benmalenfant/OpenSimRadio/docs/kx155-picture.webp

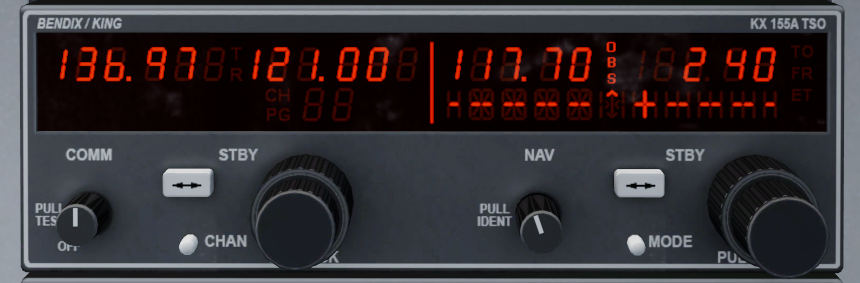
docs/kx155-picture.webp
