benmalenfant/OpenSimRadio/README.md

# OpenSimRadio
Open sourced radio stack for flight simulation (Work in progress, not finished)
