benmalenfant/OpenSimRadio/docs/kx-165a drawings.pdf

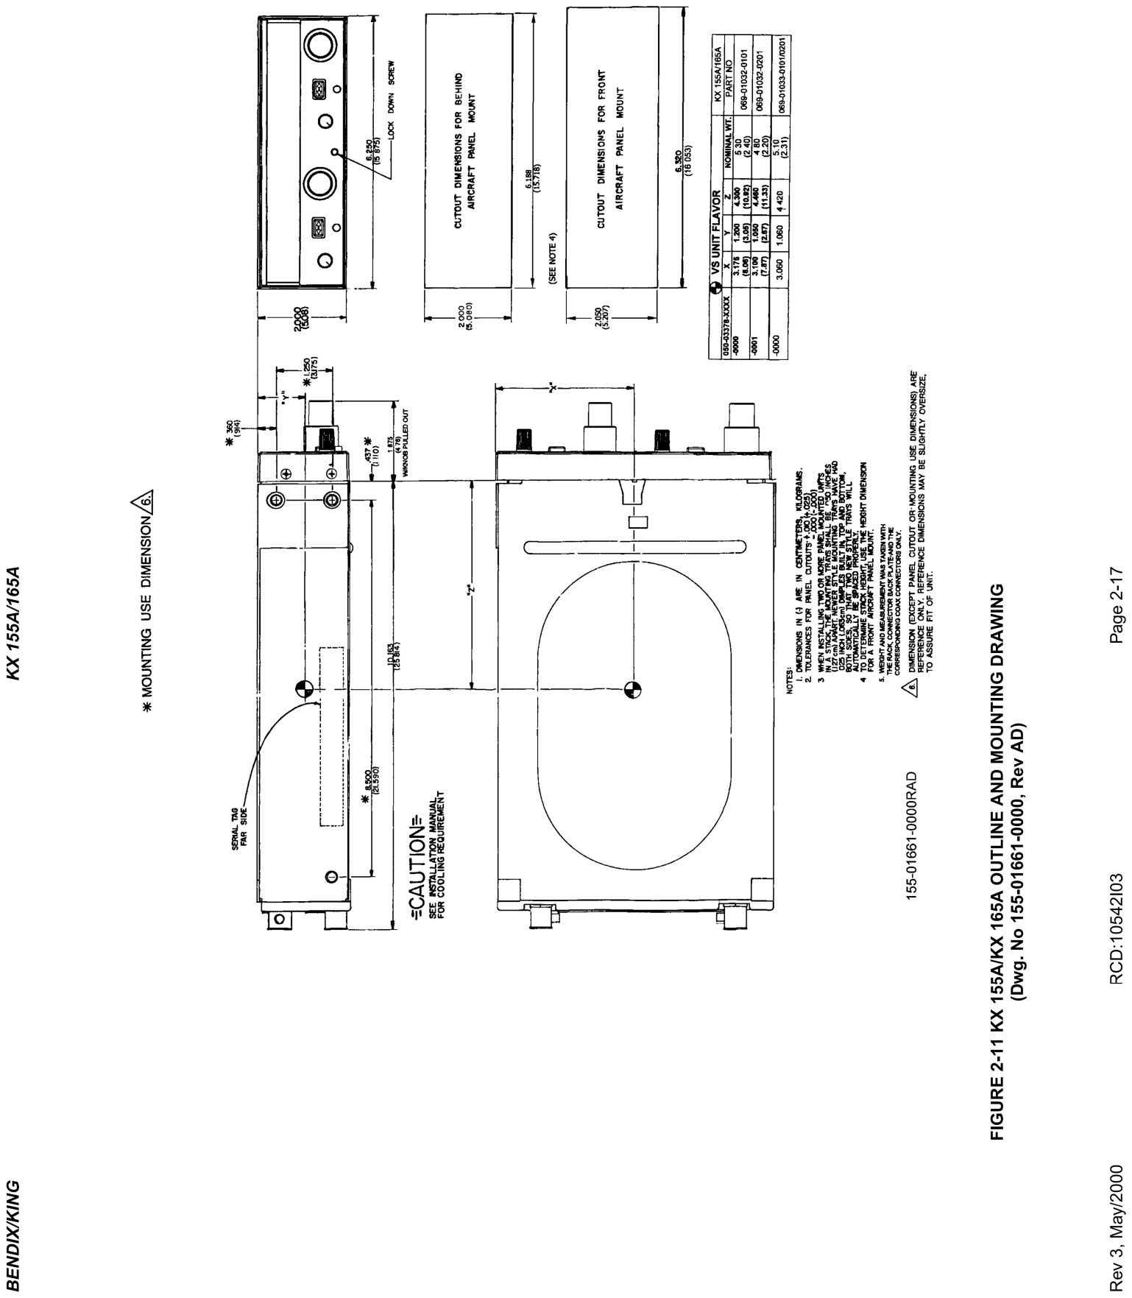
[picture p2: page 1]
