benmalenfant/OpenSimRadio/docs/KX-165_Face_Drawing.png

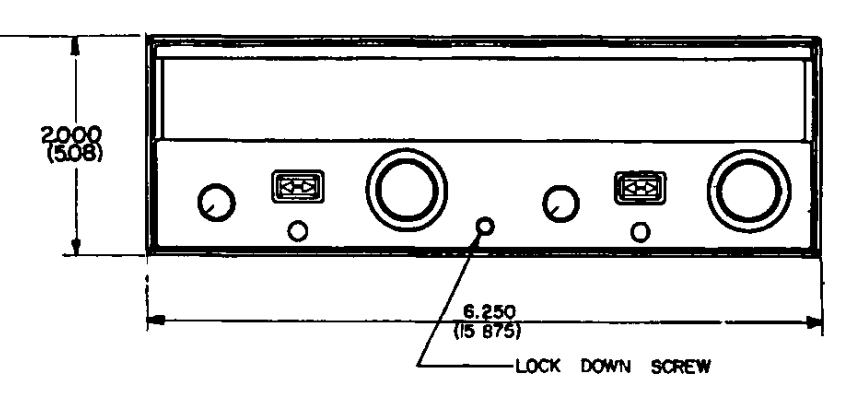
docs/KX-165_Face_Drawing.png
