benmalenfant/OpenSimRadio/(list of files, cad)

Other CAD files:
Com-Nav Unit/Mechanical/Draft.FCStd
