benmalenfant/OpenSimRadio/Com-Nav Unit/PCB/Com-Nav-Radio.kicad_pcb

## KiCad design Com-Nav Unit/PCB/Com-Nav-Radio.kicad_pcb (2025-05-04)

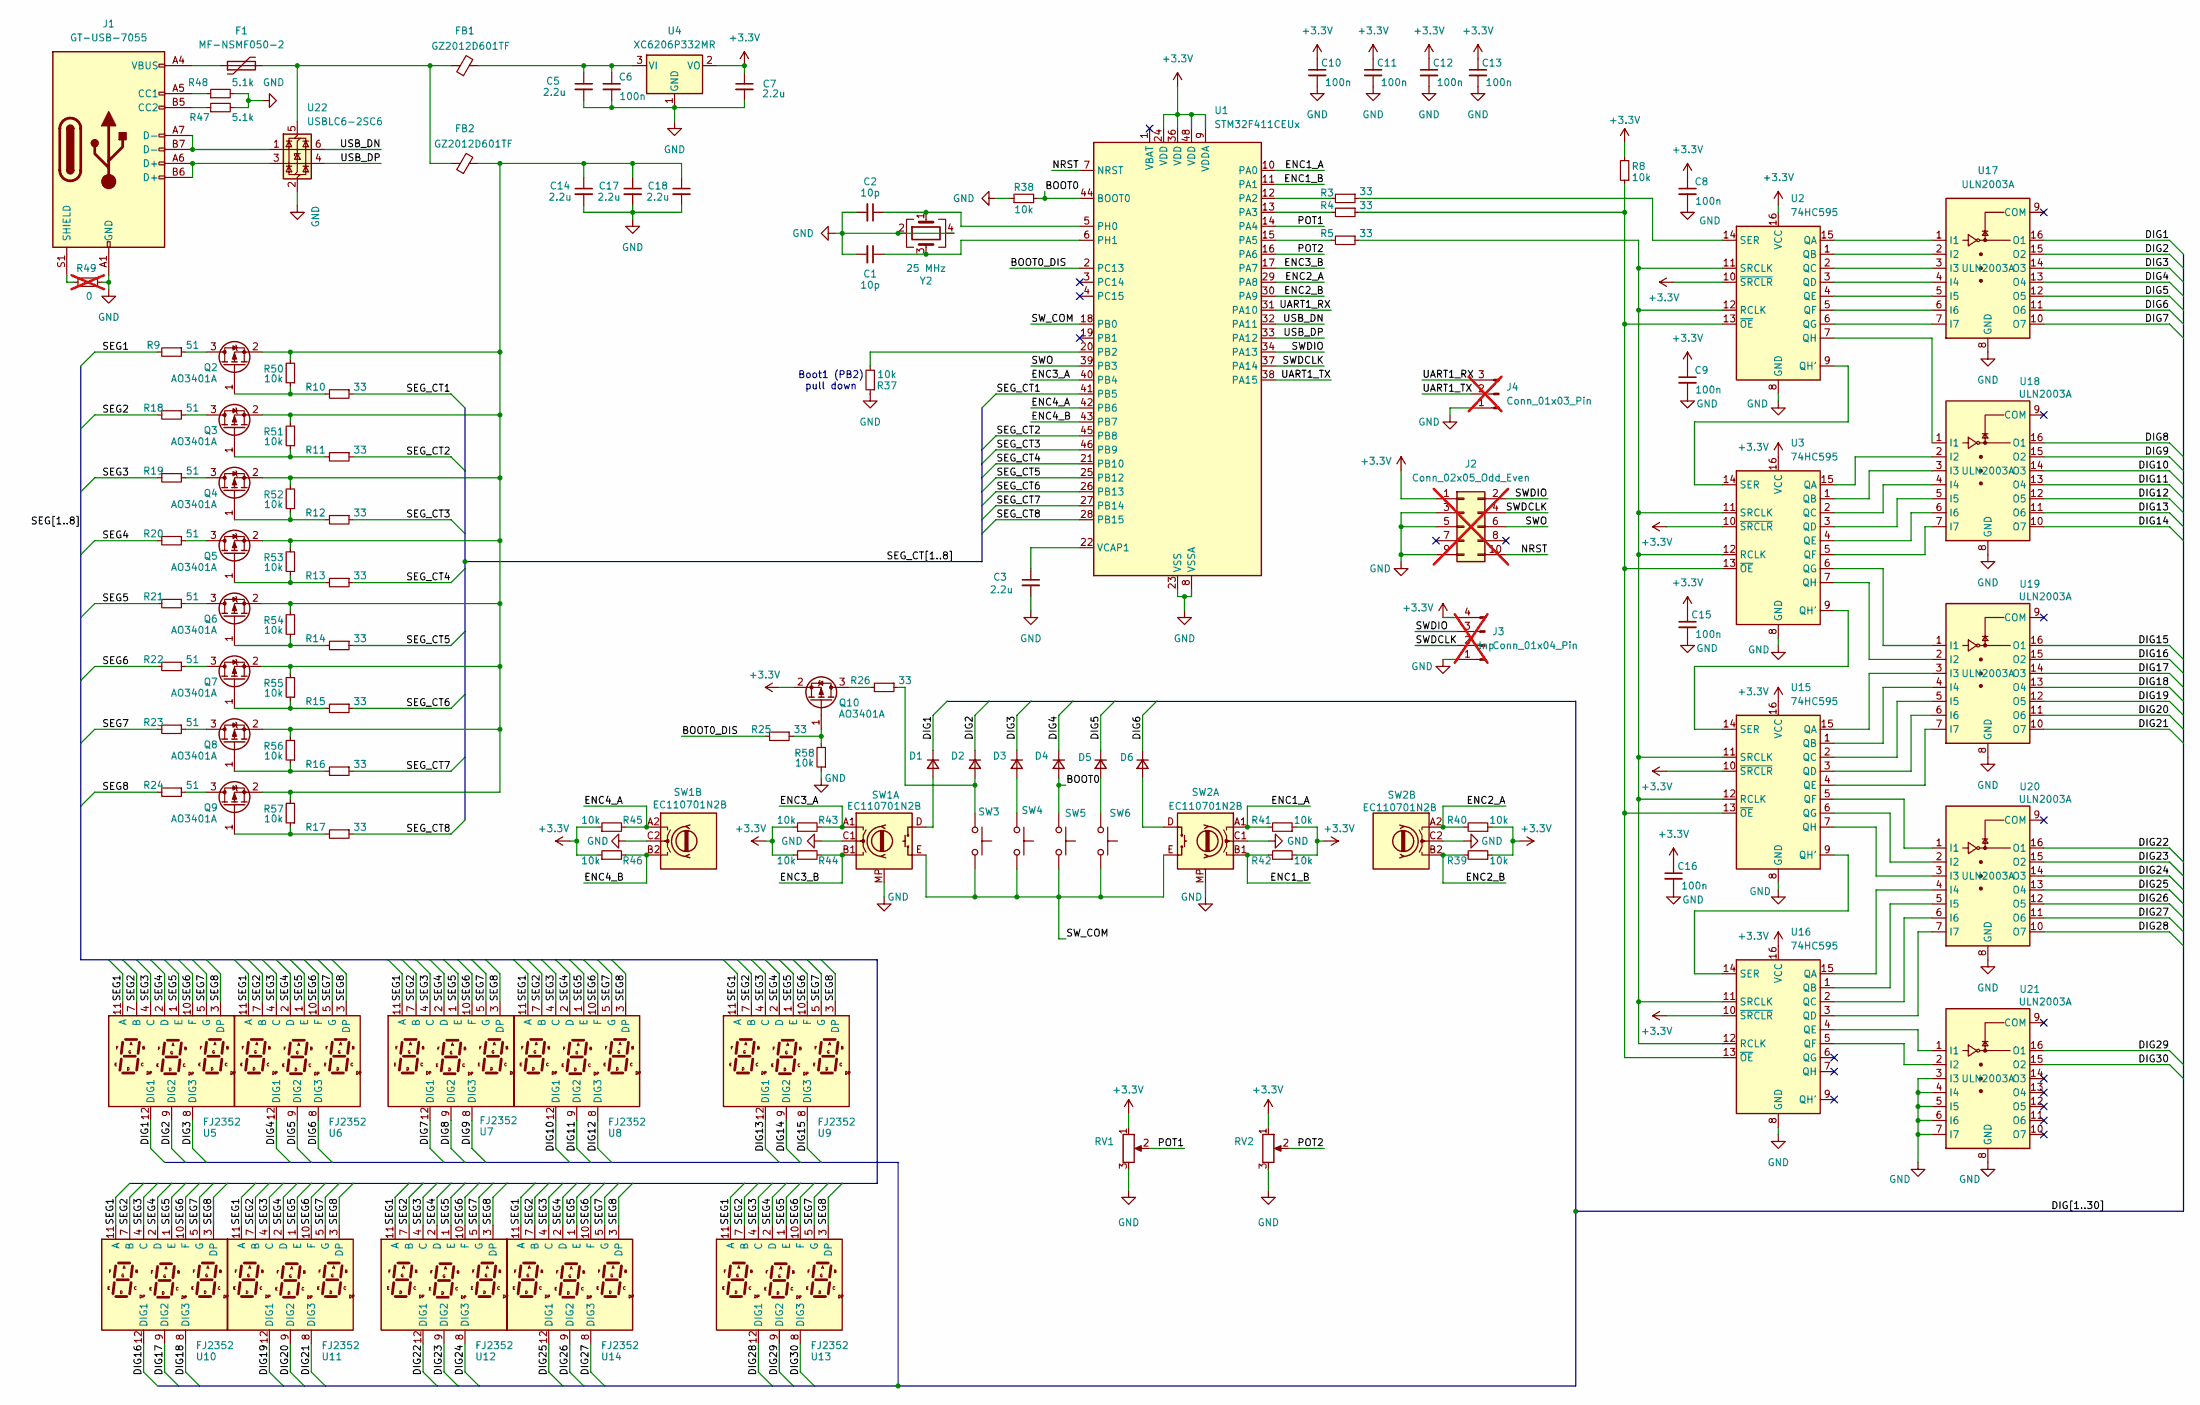
[picture p4: schematic Com-Nav-Radio.kicad_sch, Com-Nav-Radio Unit]

Parts:
C1, C2: 10p; C_0402_1005Metric
C3, C5, C7, C14, C17, C18: 2.2u; C_0603_1608Metric
C6, C8, C9, C10, C11, C12, C13, C15, C16: 100n; C_0402_1005Metric
D1, D2, D3, D4, D5, D6: 1N5819WS; D_SOD-323
F1: MF-NSMF050-2; Fuse_1206_3216Metric
FB1, FB2: GZ2012D601TF; L_0805_2012Metric
J1: GT-USB-7055; USB_C_Receptacle_G-Switch_GT-USB-7055x
J2: Conn_02x05_Odd_Even; PinHeader_2x05_P1.27mm_Vertical_SMD; not fitted
J3: Conn_01x04_Pin; PinHeader_1x04_P2.54mm_Vertical; not fitted
J4: Conn_01x03_Pin; PinHeader_1x03_P2.54mm_Vertical; not fitted
Q2, Q3, Q4, Q5, Q6, Q7, Q8, Q9, Q10: AO3401A; SOT-23
R3, R4, R5, R10, R11, R12, R13, R14, R15, R16, R17, R25, R26: 33; R_0402_1005Metric
R8, R37, R38, R39, R40, R41, R42, R43, R44, R45, R46, R50, R51, R52, R53, R54, R55, R56, R57, R58: 10k; R_0402_1005Metric
R9, R18, R19, R20, R21, R22, R23, R24: 51; R_0805_2012Metric
R47, R48: 5.1k; R_0402_1005Metric
R49: 0; R_0603_1608Metric; not fitted
RV1, RV2: RA0901N0X0D; RA0901N0X0D-HA1
SW1, SW2: EC110701N2B; EC11EBB24C03_EC110701N2B
SW3, SW4, SW5, SW6: SW_Push; SW_PUSH_6mm
U1: STM32F411CEUx; QFN-48-1EP_7x7mm_P0.5mm_EP5.6x5.6mm
U2, U3, U15, U16: 74HC595; SOIC-16_3.9x9.9mm_P1.27mm
U4: XC6206P332MR; SOT-23-3
U5, U6, U7, U8, U9, U10, U11, U12, U13, U14: FJ2352
U17, U18, U19, U20, U21: ULN2003A; SOIC-16_3.9x9.9mm_P1.27mm
U22: USBLC6-2SC6; SOT-23-6
Y2: 25 MHz; Crystal_SMD_3225-4Pin_3.2x2.5mm

Connections:
+3.3V: C7.1, C8.1, C9.1, C10.1, C11.1, C12.1, C13.1, C15.1, C16.1, J2.1, J3.4, Q10.2 (S), R8.2, R39.1, R40.1, R41.1, R42.1, R43.1, R44.1, R45.1, R46.1, RV1.1, RV2.1, U1.9 (VDDA), U1.24 (VDD), U1.36 (VDD), U1.48 (VDD), U2.10 (~SRCLR), U2.16 (VCC), U3.10 (~SRCLR), U3.16 (VCC), U4.2 (VO), U15.10 (~SRCLR), U15.16 (VCC), U16.10 (~SRCLR), U16.16 (VCC)
/BOOT0: D4.2 (A), R38.2, SW5.2, U1.44 (BOOT0)
/DIG1: D1.1 (K), U5.12 (DIG1), U17.16 (O1)
/DIG2: D2.1 (K), U5.9 (DIG2), U17.15 (O2)
/DIG3: D3.1 (K), U5.8 (DIG3), U17.14 (O3)
/DIG4: D4.1 (K), U6.12 (DIG1), U17.13 (O4)
/DIG5: D5.1 (K), U6.9 (DIG2), U17.12 (O5)
/DIG6: D6.1 (K), U6.8 (DIG3), U17.11 (O6)
/DIG7: U7.12 (DIG1), U17.10 (O7)
/DIG8: U7.9 (DIG2), U18.16 (O1)
/DIG9: U7.8 (DIG3), U18.15 (O2)
/DIG10: U8.12 (DIG1), U18.14 (O3)
/DIG11: U8.9 (DIG2), U18.13 (O4)
/DIG12: U8.8 (DIG3), U18.12 (O5)
/DIG13: U9.12 (DIG1), U18.11 (O6)
/DIG14: U9.9 (DIG2), U18.10 (O7)
/DIG15: U9.8 (DIG3), U19.16 (O1)
/DIG16: U10.12 (DIG1), U19.15 (O2)
/DIG17: U10.9 (DIG2), U19.14 (O3)
/DIG18: U10.8 (DIG3), U19.13 (O4)
/DIG19: U11.12 (DIG1), U19.12 (O5)
/DIG20: U11.9 (DIG2), U19.11 (O6)
/DIG21: U11.8 (DIG3), U19.10 (O7)
/DIG22: U12.12 (DIG1), U20.16 (O1)
/DIG23: U12.9 (DIG2), U20.15 (O2)
/DIG24: U12.8 (DIG3), U20.14 (O3)
/DIG25: U14.12 (DIG1), U20.13 (O4)
/DIG26: U14.9 (DIG2), U20.12 (O5)
/DIG27: U14.8 (DIG3), U20.11 (O6)
/DIG28: U13.12 (DIG1), U20.10 (O7)
/DIG29: U13.9 (DIG2), U21.16 (O1)
/DIG30: U13.8 (DIG3), U21.15 (O2)
/ENC1_A: R41.2, SW2.A1, U1.10 (PA0)
/ENC1_B: R42.2, SW2.B1, U1.11 (PA1)
/ENC2_A: R40.2, SW2.A2, U1.29 (PA8)
/ENC2_B: R39.2, SW2.B2, U1.30 (PA9)
/ENC3_A: R43.2, SW1.A1, U1.40 (PB4)
/ENC3_B: R44.2, SW1.B1, U1.17 (PA7)
/ENC4_A: R45.2, SW1.A2, U1.42 (PB6)
/ENC4_B: R46.2, SW1.B2, U1.43 (PB7)
/NRST: J2.10, U1.7 (NRST)
/POT1: RV1.2, U1.14 (PA4)
/POT2: RV2.2, U1.16 (PA6)
/SEG1: R9.2, U5.11 (A), U6.11 (A), U7.11 (A), U8.11 (A), U9.11 (A), U10.11 (A), U11.11 (A), U12.11 (A), U13.11 (A), U14.11 (A)
/SEG2: R18.2, U5.7 (B), U6.7 (B), U7.7 (B), U8.7 (B), U9.7 (B), U10.7 (B), U11.7 (B), U12.7 (B), U13.7 (B), U14.7 (B)
/SEG3: R19.2, U5.4 (C), U6.4 (C), U7.4 (C), U8.4 (C), U9.4 (C), U10.4 (C), U11.4 (C), U12.4 (C), U13.4 (C), U14.4 (C)
/SEG4: R20.2, U5.2 (D), U6.2 (D), U7.2 (D), U8.2 (D), U9.2 (D), U10.2 (D), U11.2 (D), U12.2 (D), U13.2 (D), U14.2 (D)
/SEG5: R21.2, U5.1 (E), U6.1 (E), U7.1 (E), U8.1 (E), U9.1 (E), U10.1 (E), U11.1 (E), U12.1 (E), U13.1 (E), U14.1 (E)
/SEG6: R22.2, U5.10 (F), U6.10 (F), U7.10 (F), U8.10 (F), U9.10 (F), U10.10 (F), U11.10 (F), U12.10 (F), U13.10 (F), U14.10 (F)
/SEG7: R23.2, U5.5 (G), U6.5 (G), U7.5 (G), U8.5 (G), U9.5 (G), U10.5 (G), U11.5 (G), U12.5 (G), U13.5 (G), U14.5 (G)
/SEG8: R24.2, U5.3 (DP), U6.3 (DP), U7.3 (DP), U8.3 (DP), U9.3 (DP), U10.3 (DP), U11.3 (DP), U12.3 (DP), U13.3 (DP), U14.3 (DP)
/SEG_CT1: R10.1, U1.41 (PB5)
/SEG_CT2: R11.1, U1.45 (PB8)
/SEG_CT3: R12.1, U1.46 (PB9)
/SEG_CT4: R13.1, U1.21 (PB10)
/SEG_CT5: R14.1, U1.25 (PB12)
/SEG_CT6: R15.1, U1.26 (PB13)
/SEG_CT7: R16.1, U1.27 (PB14)
/SEG_CT8: R17.1, U1.28 (PB15)
/SWDCLK: J2.4, J3.2, U1.37 (PA14)
/SWDIO: J2.2, J3.3, U1.34 (PA13)
/SWO: J2.6, U1.39 (PB3)
/SW_COM: SW1.E, SW2.E, SW3.1, SW4.1, SW5.1, SW6.1, U1.18 (PB0)
/USB_DN: U1.32 (PA11), U22.6 (I/O1)
/USB_DP: U1.33 (PA12), U22.4 (I/O2)
GND: C1.2, C2.2, C3.2, C5.2, C6.2, C7.2, C8.2, C9.2, C10.2, C11.2, C12.2, C13.2, C14.2, C15.2, C16.2, C17.2, C18.2, J1.A1 (GND), J1.A12 (GND), J1.B1 (GND), J1.B12 (GND), J2.3, J2.5, J2.9, J3.1, J4.1, R37.1, R38.1, R47.2, R48.2, R49.2, R58.1, RV1.3, RV2.3, SW1.C1, SW1.C2, SW1.MP, SW2.C1, SW2.C2, SW2.MP, U1.8 (VSSA), U1.23 (VSS), U1.35 (VSS), U1.47 (VSS), U1.49 (VSS), U2.8 (GND), U3.8 (GND), U4.1 (GND), U15.8 (GND), U16.8 (GND), U17.8 (GND), U18.8 (GND), U19.8 (GND), U20.8 (GND), U21.3 (I3), U21.4 (I4), U21.5 (I5), U21.6 (I6), U21.7 (I7), U21.8 (GND), U22.2 (GND), Y2.2, Y2.4
unnamed: D1.2 (A), SW1.D
unnamed: D2.2 (A), R26.1, SW3.2
unnamed: D3.2 (A), SW4.2
unnamed: D5.2 (A), SW6.2
unnamed: D6.2 (A), SW2.D
unnamed: F1.1, J1.A4 (VBUS), J1.A9 (VBUS), J1.B4 (VBUS), J1.B9 (VBUS)
unnamed: J1.A5 (CC1), R48.1
unnamed: J1.B5 (CC2), R47.1
unnamed: J1.A6 (D+), J1.B6 (D+), U22.3 (I/O2)
unnamed: J1.A7 (D-), J1.B7 (D-), U22.1 (I/O1)
unnamed: J1.S1 (SHIELD), R49.1
unnamed: J4.2, U1.38 (PA15)
unnamed: J4.3, U1.31 (PA10)
unnamed: Q2.3 (D), R9.1
unnamed: Q2.1 (G), R10.2, R50.1
unnamed: C14.1, C17.1, C18.1, FB2.2, Q2.2 (S), Q3.2 (S), Q4.2 (S), Q5.2 (S), Q6.2 (S), Q7.2 (S), Q8.2 (S), Q9.2 (S), R50.2, R51.2, R52.2, R53.2, R54.2, R55.2, R56.2, R57.2
unnamed: Q3.3 (D), R18.1
unnamed: Q3.1 (G), R11.2, R51.1
unnamed: Q4.3 (D), R19.1
unnamed: Q4.1 (G), R12.2, R52.1
unnamed: Q5.3 (D), R20.1
unnamed: Q5.1 (G), R13.2, R53.1
unnamed: Q6.3 (D), R21.1
unnamed: Q6.1 (G), R14.2, R54.1
unnamed: Q7.3 (D), R22.1
unnamed: Q7.1 (G), R15.2, R55.1
unnamed: Q8.3 (D), R23.1
unnamed: Q8.1 (G), R16.2, R56.1
unnamed: Q9.3 (D), R24.1
unnamed: Q9.1 (G), R17.2, R57.1
unnamed: Q10.3 (D), R26.2
unnamed: R3.2, U1.12 (PA2)
unnamed: R4.2, U1.13 (PA3)
unnamed: R5.2, U1.15 (PA5)
unnamed: R37.2, U1.20 (PB2)
unnamed: C2.1, U1.5 (PH0), Y2.1
unnamed: C1.1, U1.6 (PH1), Y2.3
unnamed: C3.1, U1.22 (VCAP1)
unnamed: U2.9 (QH'), U3.14 (SER)
unnamed: R3.1, U2.14 (SER)
unnamed: C5.1, C6.1, FB1.2, U4.3 (VI)
unnamed: U15.15 (QA), U19.3 (I3)
unnamed: U15.1 (QB), U19.4 (I4)
unnamed: U15.2 (QC), U19.5 (I5)
unnamed: U15.3 (QD), U19.6 (I6)
unnamed: U15.4 (QE), U19.7 (I7)
unnamed: U15.5 (QF), U20.1 (I1)
unnamed: U15.6 (QG), U20.2 (I2)
unnamed: U15.9 (QH'), U16.14 (SER)
unnamed: U15.7 (QH), U20.3 (I3)
unnamed: R5.1, U2.11 (SRCLK), U2.12 (RCLK), U3.11 (SRCLK), U3.12 (RCLK), U15.11 (SRCLK), U15.12 (RCLK), U16.11 (SRCLK), U16.12 (RCLK)
unnamed: U3.9 (QH'), U15.14 (SER)
unnamed: R4.1, R8.1, U2.13 (~OE), U3.13 (~OE), U15.13 (~OE), U16.13 (~OE)
unnamed: U16.15 (QA), U20.4 (I4)
unnamed: U16.1 (QB), U20.5 (I5)
unnamed: U16.2 (QC), U20.6 (I6)
unnamed: U16.3 (QD), U20.7 (I7)
unnamed: U16.4 (QE), U21.1 (I1)
unnamed: U16.5 (QF), U21.2 (I2)
unnamed: U2.15 (QA), U17.1 (I1)
unnamed: U2.1 (QB), U17.2 (I2)
unnamed: U2.2 (QC), U17.3 (I3)
unnamed: U2.3 (QD), U17.4 (I4)
unnamed: U2.4 (QE), U17.5 (I5)
unnamed: U2.5 (QF), U17.6 (I6)
unnamed: U2.6 (QG), U17.7 (I7)
unnamed: U2.7 (QH), U18.1 (I1)
unnamed: U3.15 (QA), U18.2 (I2)
unnamed: U3.1 (QB), U18.3 (I3)
unnamed: U3.2 (QC), U18.4 (I4)
unnamed: U3.3 (QD), U18.5 (I5)
unnamed: U3.4 (QE), U18.6 (I6)
unnamed: U3.5 (QF), U18.7 (I7)
unnamed: U3.6 (QG), U19.1 (I1)
unnamed: U3.7 (QH), U19.2 (I2)
unnamed: F1.2, FB1.1, FB2.1, U22.5 (VBUS)

Notes on the sheet:
Boot1 (PB2) pull down

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
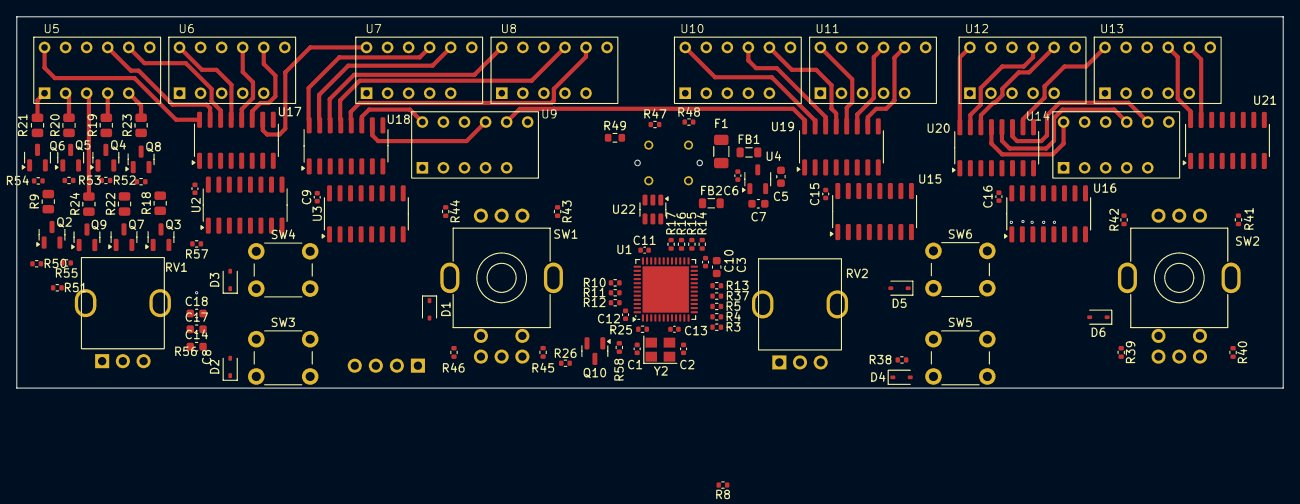
[picture p5: board Com-Nav-Radio.kicad_pcb from above]

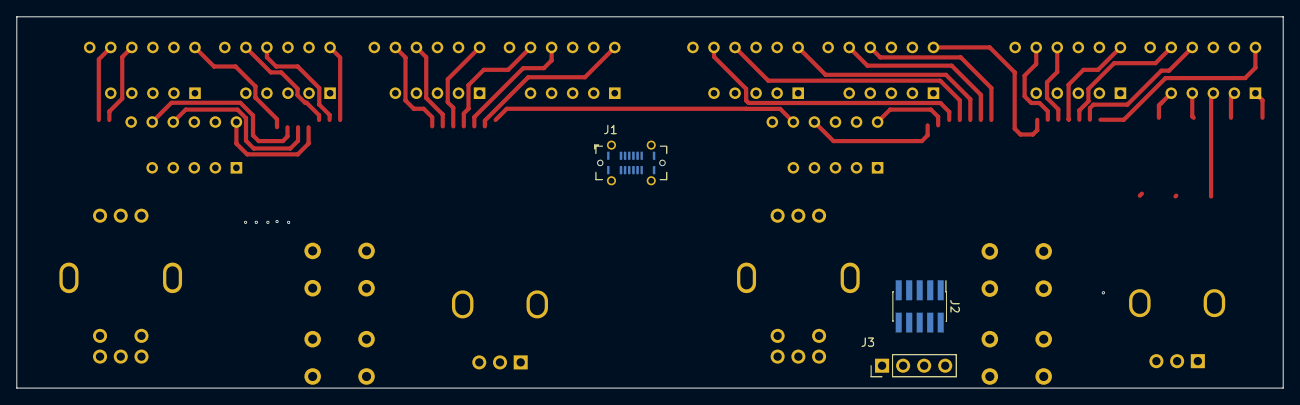
[picture p6: board Com-Nav-Radio.kicad_pcb from below]

Board: 4 copper layers, 152.8 x 44.8 mm, 113 parts (3 on the bottom side), 142 nets.
