benmalenfant/OpenSimRadio/(commit log)

2025-03-16 Demo firmware for timers
2025-03-16 Firmware working daisy chaining
2025-03-16 Firmware - Display timers complete, missing the digit update function
    [display.cpp, main.cpp]
2025-03-16 Mechanical - First draft for 7 segment placement
    [Draft.FCStd]
2025-03-16 Firmware - Invert data polarity since we are using common anode
    [display.cpp]
2025-03-16 Firmware - Changed Timings to allow time for the interrupt, might consider DMA in the future
2025-03-18 PCB - Work on schematic
    [Com-Nav-Radio.kicad_pcb, Com-Nav-Radio.kicad_sch]
2025-03-19 PCB- Sch Connect 7 segments
    [Com-Nav-Radio.kicad_pcb, Com-Nav-Radio.kicad_sch]
2025-03-22 add swdio to stm in sch, add fab outputs to gitignore
    [Com-Nav-Radio.kicad_sch]
2025-04-01 PCB - Add ferite bead, connect encoders
    [Com-Nav-Radio.kicad_pcb, Com-Nav-Radio.kicad_sch]
2025-04-06 PCB - Changed to common cathode with 2 more shift reg
    [Com-Nav-Radio.kicad_pcb, Com-Nav-Radio.kicad_sch]
2025-04-18 PCB - Add swd connector, add switches
    [Com-Nav-Radio.kicad_pcb, Com-Nav-Radio.kicad_sch]
2025-04-18 PCB - SCH - first drc run, add no connect flags
    [Com-Nav-Radio.kicad_sch]
2025-05-03 PCB - work on schematic, initial board placement
    [Com-Nav-Radio.kicad_pcb, Com-Nav-Radio.kicad_sch]
2025-05-04 PCB - Sketch routing of the 7 segments
    [Com-Nav-Radio.kicad_pcb, Com-Nav-Radio.kicad_sch]
